csunday95/bearing-openscad/changelog.md

# SCAD Origin Bearing Changelog

Started keeping track at version 0.6.0

### Terms:
 - directions:
    - build side vs terminal side - side that prints on the build head (z = 0) vis terminal side of circular bearing face
   - radial - along the vector going from the center toward the perimeter for circularly symmetric parts
   - anti-radial - opposite direction as radial
   - axial - along the vector of a shaft that would pass through the center of the bearing, perpendicular to the circular face of the bearing. Positive axial is in the terminal print direction (positive z)
   - anti-axial - opposite axial direction
   - rotational - direction of the bearing's rotation, at any point the cross product of radial and axial vectors
 - dimensions
   - width - size in rotational direction
   - height - size in axial direction
   - length - size in radial direction

# 0.6.0

 - first satisfactorily functional bearing printed with settings

 ```json
 {
    "export_v6": {
        "$fa": "0.01",
        "$fs": "0.050000000000000003",
        "cage_margin": "0.29999999999999999",
        "height": "12",
        "id": "12",
        "lip_depth": "1.3",
        "lip_thickness": "0.80000000000000004",
        "od": "28",
        "outer_thickness": "14",
        "roller_cage_margin": "0.20000000000000001",
        "roller_count": "12",
        "roller_margin": "0.75",
        "roller_radius": "2.5"
    },
 }
 ```
 ### Notes:
  - smooth rolling performance with zero thrust, decent thrust zero-load performance
  - a bit more slop than I'd like in the axial direction due to the rollers being shorter than the bevel; candidate for panelization 
  - probably can get a better insertion notch by putting it on the build head side
  - put text on the rollers / other parts in non crital areas for easier identification, best to put on non build side

# 0.7.0

 - added optional text labeling of parameters to the models, text parameters are hard coded for now
 - added versioning file
 - moved insertion notch to build side of print

# 0.7.1
 - decreased lip depth 1.3 -> 1.25, slightly reduces overhang for maybe overall better surface on axial side lip
 - decreased roller margin 0.75 -> 0.6; should decrease axial slop

### Notes:
 - try decreasing the roller cage margin 0.2 -> 0.15 maybe?
 - tried printing on P56 (pilot), but it had a lot of XY accuracy issues that made the fit pretty poor

# 0.7.2a
 - `lip_thickness` changed 0.8 -> 0.7
 - `lip_depth` changed 1.25 -> 0.85
 - `roller_cage_margin` changed 0.2 -> 0.175
 - `roller_margin` changed 0.6 -> 0.4
 - harcoded `roller_insertion_fraction` value changed to 0.975
 - hardcoded `roller_insertion_fraction` value changed 0.95 -> 0.975
 - hardcoded `label_depth` changed 0.2 -> 0.25

# 0.7.2b
 - `lip_thickness` changed 0.8 -> 0.6
 - `lip_depth` changed 1.25 -> 0.75
 - `roller_cage_margin` changed 0.2 -> 0.15
 - `roller_margin` changed 0.6 -> 0.3
 - hardcoded `roller_insertion_fraction` value changed 0.95 -> 0.98
 - hardcoded `label_depth` changed 0.2 -> 0.25

# 0.7.2c (relative to 0.7.1)
 - added `outer_id_margin` parameter with an initial value of 0.1. Increases the outer race
 id by that amount to create a tiny amount of radial wiggle room for spin & assembly.
 - `lip_thickness` changed 0.8 -> 1.0
 - `lip_depth` changed 1.25 -> 0.8
 - `roller_cage_margin` changed 0.2 -> 0.15
 - `roller_margin` changed 0.6 -> 0.45
 - hardcoded `roller_insertion_fraction` value changed 0.95 -> 0.99
 - hardcoded `label_depth` changed 0.2 -> 0.3
 - hardcoded `label_size_factor` changed 3.0 -> 2.25

### Notes:
 - printed in Keyguide; material is just too brittle to reliably remove cage parts, tends to shatter
 - extremely high lubricity and compressive strength, possibly perfect material for races, but maybe risky for
 rollers due to lack of ductility?
 - after material shrinkage, roller is slightly too long, is rubbing on the lip's sloped surface

# 0.7.3 (relative to 0.7.2c)
 - `roller_margin` changed 0.45 -> 0.55
 - hardcoded `roller_insertion_fraction` value changed 0.95 -> 1.0

### Notes:
 - printed in 3843
 - cage still way too brittle, have to increase lip thickness and roller margin back towards V6 values

# 0.7.3b (relative to 0.7.2a)
- `lip_thickness` changed 1.0 -> 1.2
- `roller_margin` changed 0.55 -> 0.6

# 0.7.3c/big (relative to 0.7.2b)
 - increased od, outer thicknes, roller radius and height to generally make a bigger bearing
 - decreased lip thickness 1.2 -> 1.1

# 0.7.4a & b
 - cage margin changed to a fraction of `roller_radius`, renamed `cage_margin_frac`
 - changed multiple others to fractional, but compute the output in bearing_exploded_tiling.scad
 before calling bearing_exploded()
 - a vs b is changed to size
 - for b, tweaked the outer race text radius outer_thickness divisor to 2.2 and inner race radius 
 divisor to 2.1 (need) to make these values more universal later

# 0.8.0a
 - made outer race outer diameter a fixed value rather than a computed one called `outer_od`
   - going to try to use 50mm diameter going forward as "standard"
   - tweaked some text radius calculations to compensate
   - changed outer_id_margin_frac to compute relative to
   `outer_od - od - roller_radius * 2`

# 0.8.0b
 - increased roller radius 2.5 -> 2.75

# 0.8.2a
 - roller_cage_margin_frac 0.0075 -> 0.0125
 - outer_id_margin_frac 0.0025 -> 0.001
 - roller_margin_frac 0.05 -> 0.055
 - cage_margin_frac 1 / 4.0 -> 1 / 3.9
 - introduced a new parameter, roller_vertical_cage_margin_frac to try
 to reduce roller rolling resistance. Adds a small axial margin to the roller/
 cage interface

# 0.8.3a 
 - added cage base thicknening variable `cage_base_thickness_frac`, started with 3%

# 0.8.3b
 - changed `cage_margin_frac` from 1 / 3.9 -> 1 / 3.75
 - changed `roller_margin_frac` from 0.05 -> 0.06
 - changed `lip_thickness_frac` from 0.0786 -> 0.075
 - changed `lip_depth_frac` from 0.02677 -> 0.025
 - changed `cage_base_thickness_frac` 0.03 -> 0.015
 - changed `roller_margin_frac` 0.06 -> 0.07

# 0.8.3c
 - changed `cage_base_thickness_frac` 0.015 -> 0.0125
 - changed `roller_margin_frac` from 0.06 -> 0.055

# 0.8.3d
 - changed `roller_margin_frac` from 0.055 -> 0.04
 - changed `outer_id_margin_frac` from 0.001 -> 0.0005; eliminate?
 - changed `roller_cage_margin_frac` form 0.0125 -> 0.0120

 # 0.8.3e
 - changed `roller_margin_frac` from 0.04 -> 0.037
 - changed `outer_id_margin_frac` from 0.0005 -> 0.0000; eliminate?
 - changed `roller_cage_margin_frac` back form 0.0120 -> 0.0125
