csunday95/bearing-openscad/parts/version.scad

VERSION = "0.8.3J";
