csunday95/bearing-openscad/(list of files, cad)

Other CAD files:
parts/bearing_test.scad
