csunday95/bearing-openscad/(commit log)

2022-02-14 paramaterized parts further, added split cage
    [bearing_exploded.scad, bearing_exploded_tiling.scad, cage.scad, cage_split.scad, inner_race.scad, notched_shaft.scad, outer_race.scad]
2022-02-14 adding start to stand code
    [stand.scad]
2022-02-14 added square notch script; using in stand example
    [radial_square_notches.scad, stand.scad]
2022-02-16 fixed some dimension issues
    [bearing.scad, bearing_exploded.scad, bearing_exploded_tiling.scad, bearing_test.scad, cage.scad, cage_split.scad, inner_race.scad, outer_race.scad]
2022-02-20 up to v6 now, current bearing works pretty well
    [bearing_exploded.scad, bearing_exploded_tiling.scad, bearing_test.scad, cage_split.scad, roller_spacer.scad]
2022-02-21 adding changelog; adding text to rollers
    [bearing_exploded.scad]
2022-02-24 0.7.2a&b with some physical parameter tweaks
    [bearing_exploded.scad, bearing_exploded_tiling.scad, version.scad]
2022-02-26 continuing to iterate V0.7
    [bearing_exploded.scad, bearing_exploded_tiling.scad, outer_race.scad, version.scad]
2022-02-26 moving util scripts to submodule
    [bearing_exploded.scad, radial_square_notches.scad, stand.scad]
2022-03-03 up to version 0.7.4a
    [bearing_exploded.scad, bearing_exploded_tiling.scad, version.scad]
2022-03-10 added fractional erosion of outer race id; current settings prints way too small
    - need to add to inner race too
    - added because first layer / adhesion region tends to run bigger than
    the upper overhang region
    [bearing_exploded.scad, bearing_exploded_tiling.scad, outer_race.scad, version.scad]
2022-03-31 up to V0.8.2a; added axial roller spacing
    [bearing_exploded.scad, bearing_exploded_tiling.scad, cage_split.scad, inner_race.scad, version.scad]
2022-04-13 up to V0.8.3e, which was pretty successful with full paramaterization
    [bearing_exploded.scad, bearing_exploded_tiling.scad, version.scad]
2022-05-10 adding 0.8.3I values
    [bearing_exploded.scad, bearing_exploded_tiling.scad, version.scad]
2022-08-17 tweaking parameters for small bearings
    [bearing_exploded_tiling.scad, version.scad]
